MagnusThome/Simracing-Brake-Pedal-Load-Cell-Conversion/(threads)

Thread 1 (2023-07-02):

How to?

TiltGlory, 2023-07-02:
Hello dear tech God. I Hope tò tò not annoy you with my questions but i'm surely not an Expert in this case.
I was planning to put a 50kg gauge instead, do i have tò change something? Resistance? Capacitor? Code?
I am putting this on csl pedals, can i upload the code as Is or Need to delete the g29 parts?

MagnusThome, 2023-07-02:
No changes needed as fas as I know. The only importan thing is that you use a decent amount of the max load so the signal from the sensor isnt't just at the very very low or very very high en of it's output but really use it's intended force range :-)

TiltGlory, 2023-07-02:
Thank you very much mate. Im so pumped for this mod. People like you make the Sim racing comunity great! :)
